dzalf/A-very-nice-thermometer/(list of files, drawings)

Other design files:
cuteThermometer/cuteThermometer.dsn
cuteThermometer/DaughterBoard/daughterDisplay/daughterDisplay.dsn
