dzalf/A-very-nice-thermometer/cuteThermometer/cuteThermometer.kicad_pcb

## KiCad design cuteThermometer/cuteThermometer.kicad_pcb (2019-02-19)

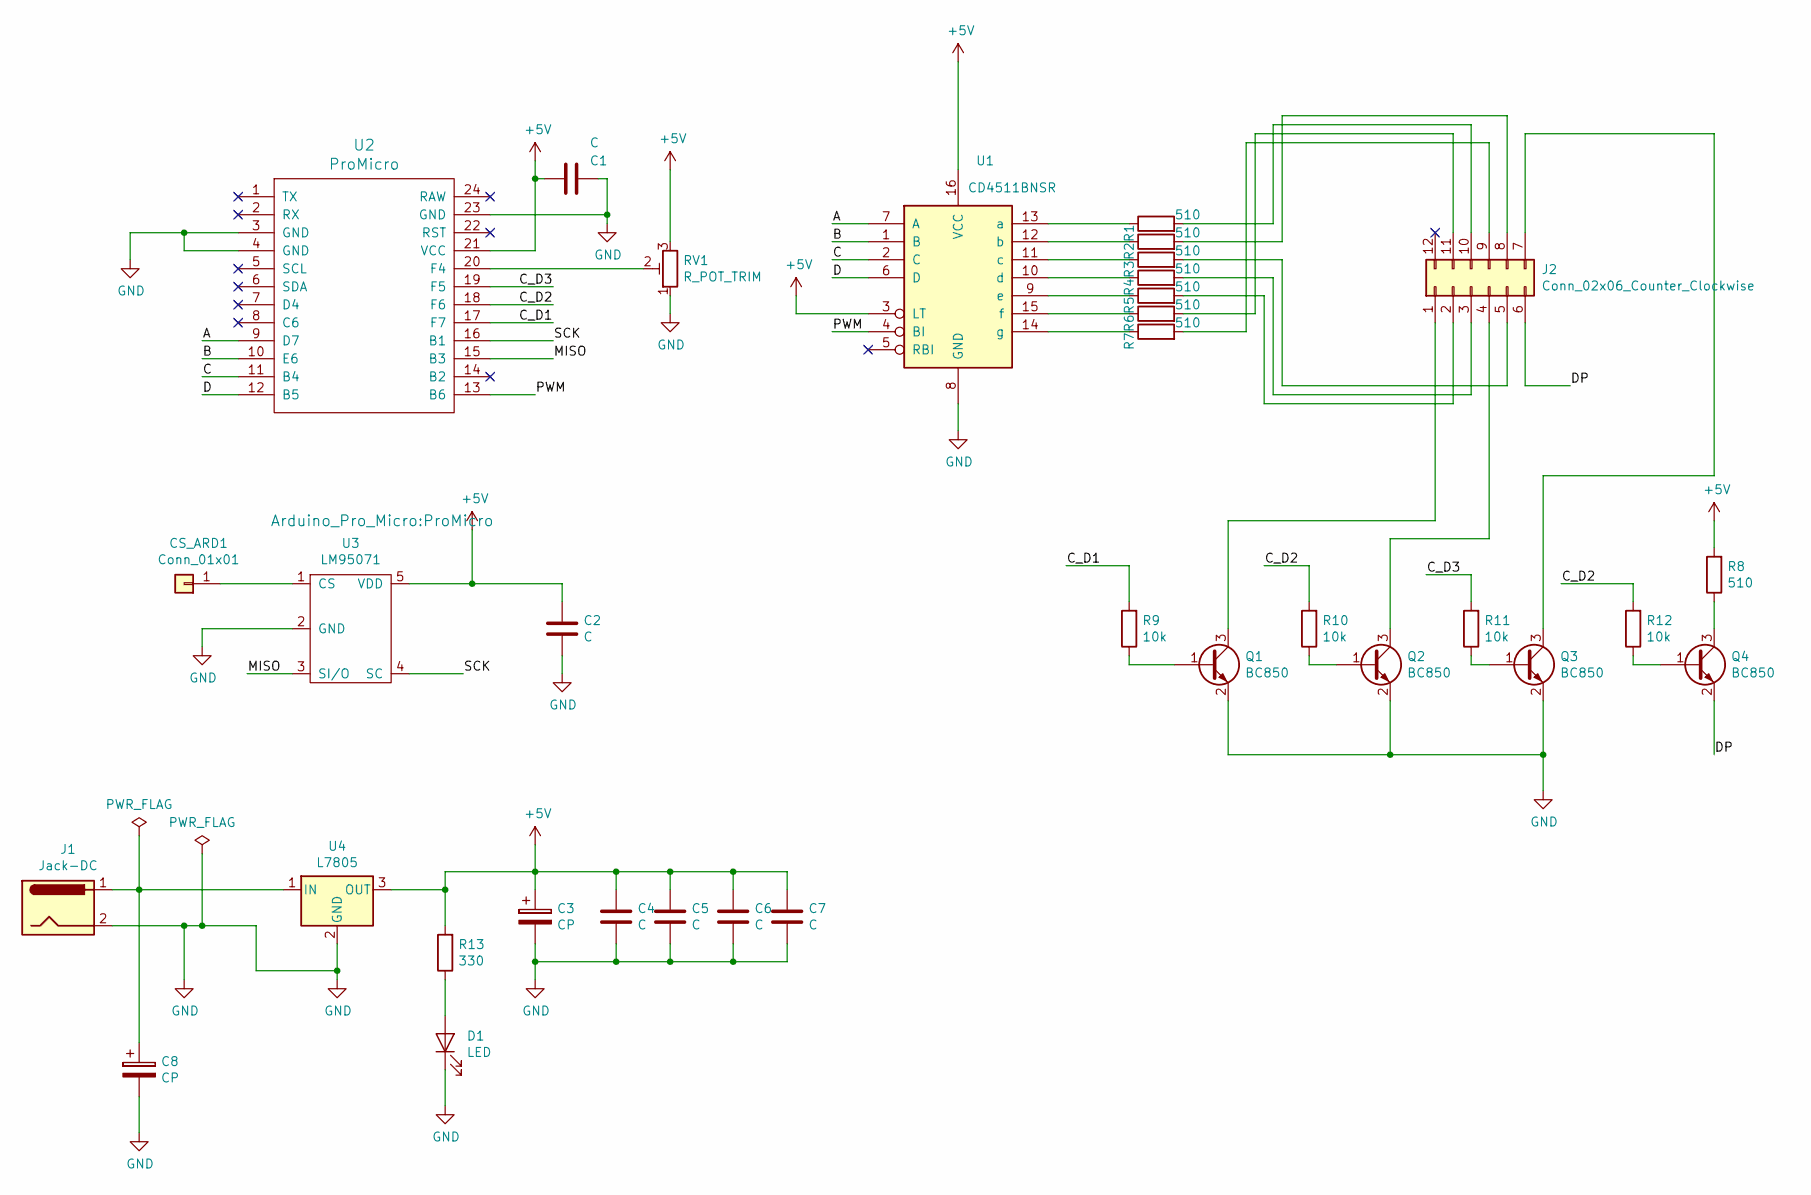
[picture p6: schematic cuteThermometer.sch]

Parts:
C1, C2, C4, C5, C6, C7: C; C_0805_2012Metric_Pad1.15x1.40mm_HandSolder
C3, C8: CP; CP_Elec_4x5.4
CS_ARD1: Conn_01x01; PinHeader_1x01_P1.00mm_Vertical
D1: LED; LED_1206_3216Metric_Pad1.42x1.75mm_HandSolder
J1: Jack-DC; BarrelJack_Wuerth_6941xx301002
J2: Conn_02x06_Counter_Clockwise; PinHeader_2x06_P2.54mm_Vertical
Q1, Q2, Q3, Q4: BC850; SOT-23
R1, R2, R3, R4, R5, R6, R7, R8: 510; R_0805_2012Metric_Pad1.15x1.40mm_HandSolder
R9, R10, R11, R12: 10k; R_0805_2012Metric_Pad1.15x1.40mm_HandSolder
R13: 330; R_0805_2012Metric_Pad1.15x1.40mm_HandSolder
RV1: R_POT_TRIM; Potentiometer_Trimmer-EVM3E
U1: CD4511BNSR; SOP-16_4.4x10.4mm_P1.27mm
U2: ProMicro
U3: LM95071; SOT-23-5_HandSoldering
U4: L7805; TO-252-3_TabPin2

Connections:
+5V: C1.2, C2.1, C3.1, C4.1, C5.1, C6.1, C7.1, R8.2, R13.2, RV1.3, U1.3 (LT), U1.16 (VCC), U2.21 (VCC), U3.5 (VDD), U4.3 (OUT)
/A: U1.7 (A), U2.9 (D7)
/B: U1.1 (B), U2.10 (E6)
/C: U1.2 (C), U2.11 (B4)
/C_D1: R9.2, U2.17 (F7)
/C_D2: R10.2, R12.2, U2.18 (F6)
/C_D3: R11.2, U2.19 (F5)
/D: U1.6 (D), U2.12 (B5)
/DP: J2.6, Q4.2 (E)
/MISO: U2.15 (B3), U3.3 (SI/O)
/PWM: U1.4 (BI), U2.13 (B6)
/SCK: U2.16 (B1), U3.4 (SC)
GND: C1.1, C2.2, C3.2, C4.2, C5.2, C6.2, C7.2, C8.2, D1.1 (K), J1.2, Q1.2 (E), Q2.2 (E), Q3.2 (E), RV1.1, U1.8 (GND), U2.3 (GND), U2.4 (GND), U2.23 (GND), U3.2 (GND), U4.2 (GND)
unnamed: C8.1, J1.1, U4.1 (IN)
unnamed: CS_ARD1.1, U3.1 (CS)
unnamed: D1.2 (A), R13.1
unnamed: J2.1, Q1.3 (C)
unnamed: J2.2, R5.2
unnamed: J2.3, R4.2
unnamed: J2.4, Q2.3 (C)
unnamed: J2.5, R3.2
unnamed: J2.7, Q3.3 (C)
unnamed: J2.8, R2.2
unnamed: J2.9, R7.2
unnamed: J2.10, R1.2
unnamed: J2.11, R6.2
unnamed: Q1.1 (B), R9.1
unnamed: Q2.1 (B), R10.1
unnamed: Q3.1 (B), R11.1
unnamed: Q4.1 (B), R12.1
unnamed: Q4.3 (C), R8.1
unnamed: R1.1, U1.13 (a)
unnamed: R2.1, U1.12 (b)
unnamed: R3.1, U1.11 (c)
unnamed: R4.1, U1.10 (d)
unnamed: R5.1, U1.9 (e)
unnamed: R6.1, U1.15 (f)
unnamed: R7.1, U1.14 (g)
unnamed: RV1.2, U2.20 (F4)

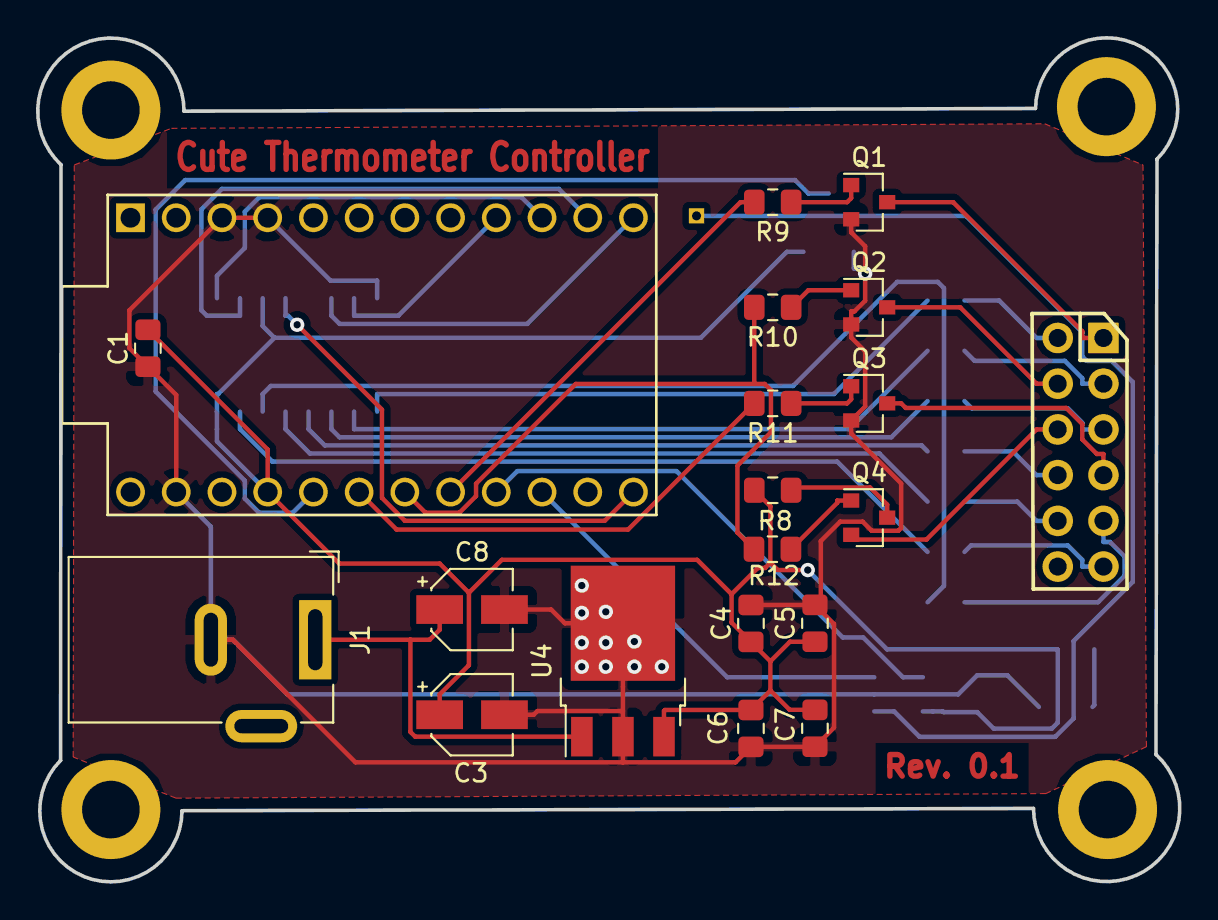
[picture p7: board cuteThermometer.kicad_pcb from above]

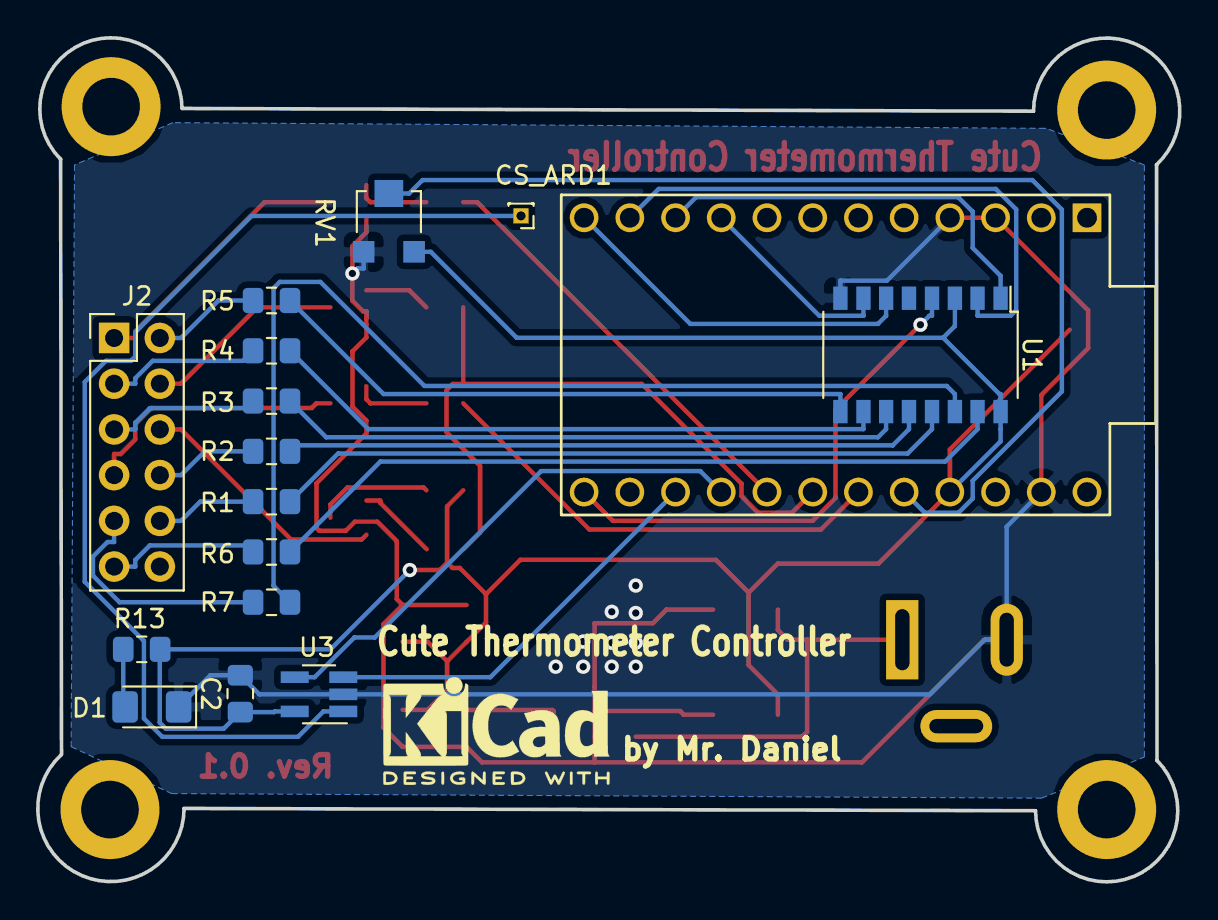
[picture p8: board cuteThermometer.kicad_pcb from below]

Board: 2 copper layers, 63.4 x 46.9 mm, 38 parts (16 on the bottom side), 39 nets.

Other parts of the board:
M1, M2, M3, M4: MountingHole_3.2mm_M3_ISO14580_Pad
