dzalf/A-very-nice-thermometer/cuteThermometer/DaughterBoard/daughterDisplay/daughterDisplay.kicad_pcb

## KiCad design cuteThermometer/DaughterBoard/daughterDisplay/daughterDisplay.kicad_pcb (2019-02-19)

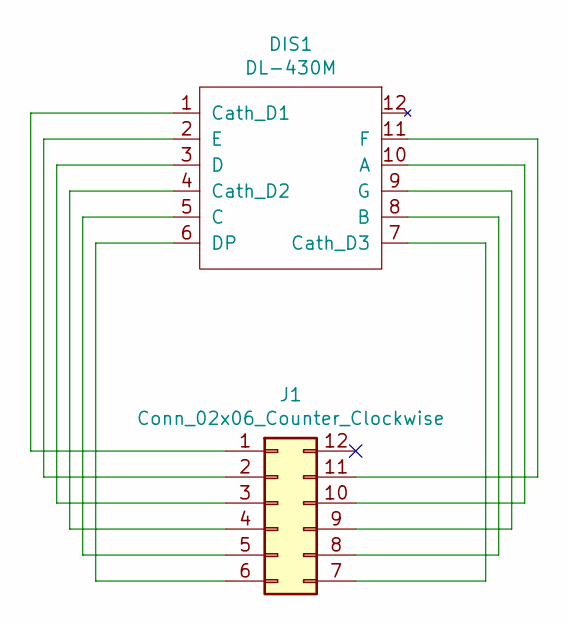
[picture p9: schematic daughterDisplay.sch]

Parts:
DIS1: DL-430M; DIP-12_W7.62mm_Socket_LongPads
J1: Conn_02x06_Counter_Clockwise; PinHeader_2x06_P2.54mm_Vertical

Connections:
unnamed: DIS1.1 (Cath_D1), J1.1
unnamed: DIS1.2 (E), J1.2
unnamed: DIS1.3 (D), J1.3
unnamed: DIS1.4 (Cath_D2), J1.4
unnamed: DIS1.5 (C), J1.5
unnamed: DIS1.6 (DP), J1.6
unnamed: DIS1.7 (Cath_D3), J1.7
unnamed: DIS1.8 (B), J1.8
unnamed: DIS1.9 (G), J1.9
unnamed: DIS1.10 (A), J1.10
unnamed: DIS1.11 (F), J1.11

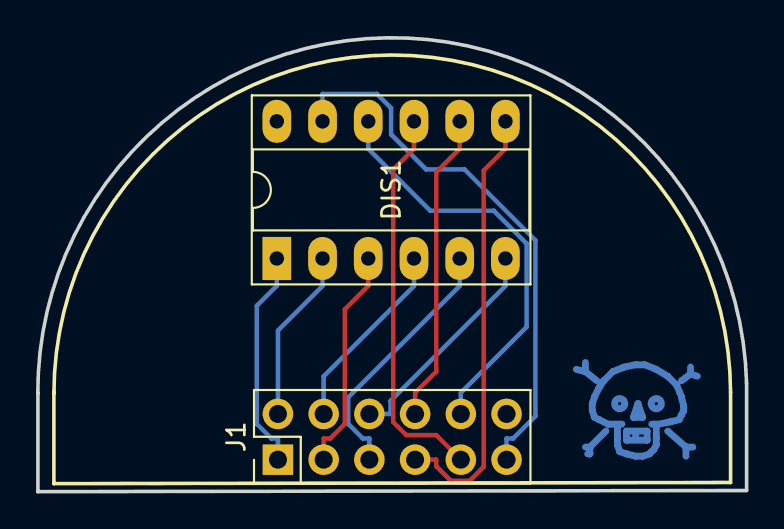
[picture p10: board daughterDisplay.kicad_pcb from above]

Board: 2 copper layers, 39.4 x 25.2 mm, 3 parts (1 on the bottom side), 11 nets.

Other parts of the board:
by Mr. Dano: Symbol_Danger_CopperTop_Small
