dzalf/A-very-nice-thermometer/(commit log)

2019-02-19 Add files via upload
    This folder contains the two main PCB designs for the processing board and the daughter display board
    [cuteThermometer.dsn, cuteThermometer.kicad_pcb, cuteThermometer.sch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]
2019-02-19 Add files via upload
    Arduino code for the thermometer
2019-02-19 Update firmware.ino
    Commented the code and corrected variable declaration issues
    [firmware.ino]
